Git-cdy/-/git.png

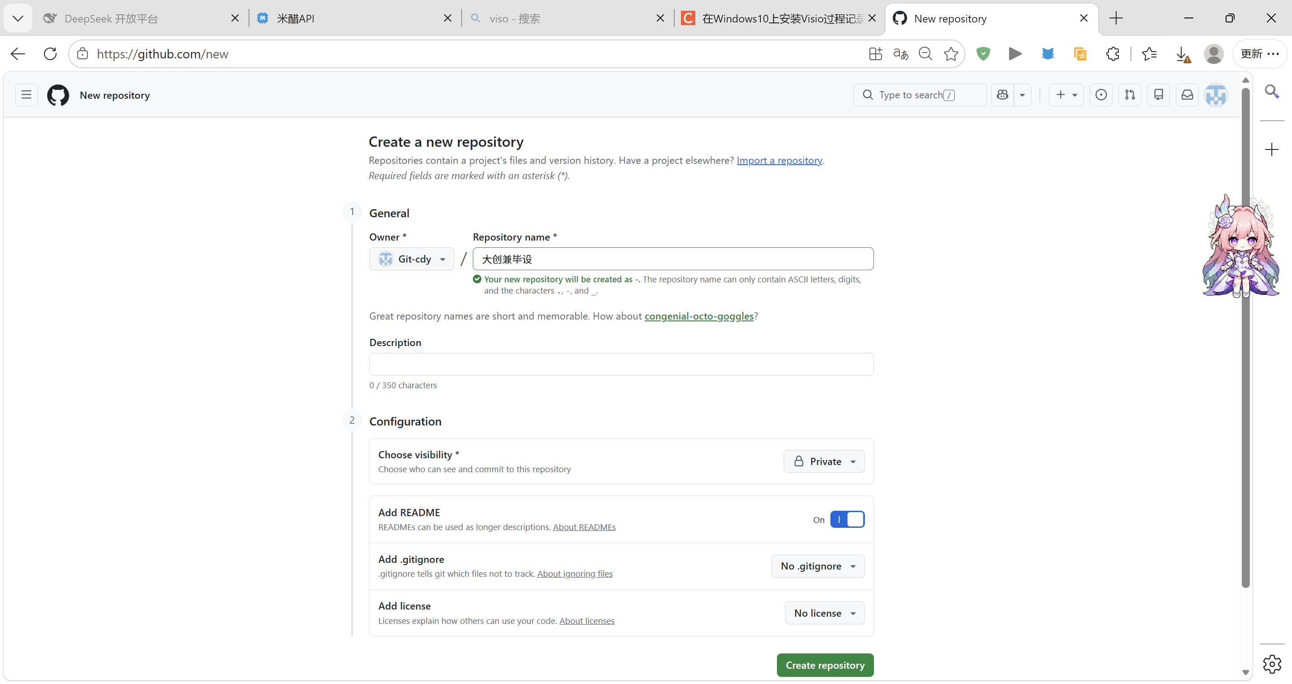
git.png
