Git-cdy/-/毕业设计/code/stm32/STM32_CDY/Tests/calibration_guide.txt

========== 土壤湿度传感器标定指南 ==========

步骤 1：干燥状态标定
  1. 烧录当前代码
  2. 打开串口监视器
  3. 让传感器完全干燥（不接触水）
  4. 观察 10 秒，记录 [Soil_Moisture] 原始 ADC 值 的平均值
  5. 记为 DRY_ADC = ___________

步骤 2：饱和状态标定
  1. 将传感器完全泡在水中
  2. 观察 10 秒，记录 [Soil_Moisture] 原始 ADC 值 的平均值
  3. 记为 WET_ADC = ___________

步骤 3：更新标定参数
  1. 打开 soil_moisture.h
  2. 修改：
     #define SOIL_DRY_ADC_VALUE    DRY_ADC
     #define SOIL_WET_ADC_VALUE    WET_ADC
  3. 重新编译烧录

步骤 4：验证
  1. 干燥时应显示 0-5%
  2. 饱和时应显示 95-100%
  3. 中间状态应线性变化

========== 噪声处理 ==========

如果泡水时偶尔跳到 10-20%，说明：
  - 可能是接触不良或传感器表面有气泡
  - 增加采样次数（目前是 10 次）
  - 或增加滤波（移动平均）

当前采样：10 次平均
建议改为：20 次平均（更稳定，但响应变慢）

========== 完成后 ==========

删除 soil_moisture.c 中的 printf("[Soil_Moisture] 原始 ADC 值: %d\r\n", *adc_value);
这样可以减少串口输出，提高系统效率。
