Git-cdy/-/毕业设计/code/stm32/STM32_CDY/Driver/key.c

#include "key.h"

// ================== 按键变量定义 ==================
volatile uint8_t Key_Down        = 0;
volatile uint8_t Key_Press_Count = 0;

// ================== 消抖变量（去掉 static，让 main.c 可见） ==================
uint32_t  key_last_time   = 0;
uint8_t   key_state       = 0;     // 0=释放，1=按下

// ================== 按键初始化 ==================
void KEY_Init(void)
{
    GPIO_InitTypeDef  GPIO_InitStructure;
    EXTI_InitTypeDef  EXTI_InitStructure;
    NVIC_InitTypeDef  NVIC_InitStructure;

    // -------- GPIO 初始化（内部下拉） --------
    RCC_APB2PeriphClockCmd(RCC_APB2Periph_GPIOA, ENABLE);

    GPIO_InitStructure.GPIO_Pin   = KEY1_GPIO_PIN;
    GPIO_InitStructure.GPIO_Mode  = GPIO_Mode_IPD;
    GPIO_InitStructure.GPIO_Speed = GPIO_Speed_50MHz;
    GPIO_Init(KEY1_GPIO_PORT, &GPIO_InitStructure);

    // -------- EXTI 初始化（PA0） --------
    RCC_APB2PeriphClockCmd(RCC_APB2Periph_AFIO, ENABLE);
    GPIO_EXTILineConfig(GPIO_PortSourceGPIOA, GPIO_PinSource0);

    EXTI_InitStructure.EXTI_Line    = EXTI_Line0;
    EXTI_InitStructure.EXTI_Mode    = EXTI_Mode_Interrupt;
    EXTI_InitStructure.EXTI_Trigger = EXTI_Trigger_Rising;
    EXTI_InitStructure.EXTI_LineCmd = ENABLE;
    EXTI_Init(&EXTI_InitStructure);

    // -------- NVIC 初始化 --------
    NVIC_InitStructure.NVIC_IRQChannel                   = EXTI0_IRQn;
    NVIC_InitStructure.NVIC_IRQChannelPreemptionPriority = 2;
    NVIC_InitStructure.NVIC_IRQChannelSubPriority        = 2;
    NVIC_InitStructure.NVIC_IRQChannelCmd                = ENABLE;
    NVIC_Init(&NVIC_InitStructure);
}

// ================== 中断服务函数 ==================
void EXTI0_IRQHandler(void)
{
    if (EXTI_GetITStatus(EXTI_Line0) != RESET)
    {
        EXTI_ClearITPendingBit(EXTI_Line0);
    }
}
